jamarju/c64_test_tools/(threads)

Thread 2 (2018-07-21):

c64 dram test mega2560

toms001, 2018-07-21:
Hi,
just uploaded the c64 dram test to a ordinary mega2560 without any wires.
The test PASSes every time without an attached dram. How is this possible?
Regards,
Thomas

jamarju, 2018-07-21:
The mega2560 version of the RAM test outputs pass/fail on the serial output, unlike the 328p version, which uses the LED.

toms001, 2018-07-21:
That is not what i meant... if you have a mega2560 with nothing connected, it always says PASS.
I expected a different result with _no_ 64k x 4 connected

jamarju, 2018-07-21:
Ok, ok sorry, I see what you mean. Let me figure out what's going on here.

jamarju, 2018-07-21:
If you have a known working RAM chip wired up, could you please try the following change in line 118 of `w()`?

Replace this:
```
    PORTF &= 0b11110000;                              // ... no pull-ups
```

with this:
```
    PORTF |= 0b00001111;                              // keep pull-ups
```

Apparently written data gets latched by the pin circuitry or stored up in some small capacitance somehow. Pulling up the inputs before reading should pass the '1111' test and fail the others.

Closed 2018-07-22.

Thread 4 (2020-05-24):

Test says fail PLA but in another C64 the chip works normally

leonpierre, 2020-05-24:
I flashed your PLA test program to an Arduino Uno and wired it to the PLA (8700-001) as declared and figured out that with a working PLA (Fujitsu 251064-01) everything looks OK but with the mentioned MOS 8700-001 I got LED flashes -> FAILED.

So if I put the "failed" 8700-001 to a working C64 everything is good! I have a video of the setup here: https://www.youtube.com/watch?v=KTHi8Ji6yds

Btw. any idea what could be wrong with this image after boot: https://imgur.com/a/6CjX6wW

Thank you.

jamarju, 2020-05-24:
You are getting two errors (1 flash + 3 flashes), so the faulty pins are F0 and F2. Can you double check the wiring especially on those two pins? Does the high half (F4...F7) also show errors?

No idea about your boot image, but looks like RAM to me according to the pictorial guide: https://derbian.webs.com/c64diag/index.htm

leonpierre, 2020-05-24:
I wired it according to your PLA Test draft.

One question:
PLA F2/6 --- C4  | [ ]A4/SDA
PLA F2/7 --- C5  | [ ]A5/SCL

is this by intention to wire F2 to A4 and A5? Because I did it like

PLA F2/6 --- C4  | [ ]A4/SDA
PLA F3/7 --- C5  | [ ]A5/SCL <==== F3 not F2

jamarju, 2020-05-24:
Yes, that was a typo. You're right, Arduino A5 should go to PLA F3.

As for your original problem, try adding a couple more nops in the peek function. Ie: instead of this:

```
  asm("nop"); // 62.5 ns
  asm("nop"); // 62.5 ns
```

Do this:

```
  asm("nop"); // 62.5 ns
  asm("nop"); // 62.5 ns
  asm("nop"); // 62.5 ns
  asm("nop"); // 62.5 ns
```

That will give twice as much time for the PLA to propagate the signals.

leonpierre, 2020-05-25:
I did your changes and tested it again with equal results. Here is a video of the same setup but with Fujitsu 251064-01 instead of MOS 8700-001 PLA:

https://www.youtube.com/watch?v=bH1ezJzycxE

It's weird for me that both PLA IC's are working in a real C64 but not with your PLA test. Any suggestions what could be wrong?

Thank you!

jamarju, 2020-05-25:
Did you connect /CE to GND? It's hard to tell in your video but it seems to me that you left it floating.

leonpierre, 2020-05-25:
Nope, but if I connect /CE to GND I have permanent LED flashes.

jamarju, 2020-05-25:
Can you record another video of the permanent flashes while /CE is connected to GND?

leonpierre, 2020-05-27:
Voila: https://youtu.be/ocNNEUnGQsc

jamarju, 2020-05-28:
That chip is PASSING the test.

A failure is indicated by a 1 second pause followed by flashing a number of times depending on the erroring pin, followed by another 1 second pause.

Closed 2020-05-28.
