jamarju/c64_test_tools/c64_rom_test/charom.h

// GENERATED WITH:
// xxd -i charom.bin >charom.h
#ifndef __CHAROM_H__
#define __CHAROM_H__

#include <avr/pgmspace.h>

const PROGMEM unsigned char characters_901225_01_bin[] = {
  0x3c, 0x66, 0x6e, 0x6e, 0x60, 0x62, 0x3c, 0x00, 0x18, 0x3c, 0x66, 0x7e,
  0x66, 0x66, 0x66, 0x00, 0x7c, 0x66, 0x66, 0x7c, 0x66, 0x66, 0x7c, 0x00,
  0x3c, 0x66, 0x60, 0x60, 0x60, 0x66, 0x3c, 0x00, 0x78, 0x6c, 0x66, 0x66,
  0x66, 0x6c, 0x78, 0x00, 0x7e, 0x60, 0x60, 0x78, 0x60, 0x60, 0x7e, 0x00,
  0x7e, 0x60, 0x60, 0x78, 0x60, 0x60, 0x60, 0x00, 0x3c, 0x66, 0x60, 0x6e,
  0x66, 0x66, 0x3c, 0x00, 0x66, 0x66, 0x66, 0x7e, 0x66, 0x66, 0x66, 0x00,
  0x3c, 0x18, 0x18, 0x18, 0x18, 0x18, 0x3c, 0x00, 0x1e, 0x0c, 0x0c, 0x0c,
  0x0c, 0x6c, 0x38, 0x00, 0x66, 0x6c, 0x78, 0x70, 0x78, 0x6c, 0x66, 0x00,
  0x60, 0x60, 0x60, 0x60, 0x60, 0x60, 0x7e, 0x00, 0x63, 0x77, 0x7f, 0x6b,
  0x63, 0x63, 0x63, 0x00, 0x66, 0x76, 0x7e, 0x7e, 0x6e, 0x66, 0x66, 0x00,
  0x3c, 0x66, 0x66, 0x66, 0x66, 0x66, 0x3c, 0x00, 0x7c, 0x66, 0x66, 0x7c,
  0x60, 0x60, 0x60, 0x00, 0x3c, 0x66, 0x66, 0x66, 0x66, 0x3c, 0x0e, 0x00,
  0x7c, 0x66, 0x66, 0x7c, 0x78, 0x6c, 0x66, 0x00, 0x3c, 0x66, 0x60, 0x3c,
  0x06, 0x66, 0x3c, 0x00, 0x7e, 0x18, 0x18, 0x18, 0x18, 0x18, 0x18, 0x00,
  0x66, 0x66, 0x66, 0x66, 0x66, 0x66, 0x3c, 0x00, 0x66, 0x66, 0x66, 0x66,
  0x66, 0x3c, 0x18, 0x00, 0x63, 0x63, 0x63, 0x6b, 0x7f, 0x77, 0x63, 0x00,
  0x66, 0x66, 0x3c, 0x18, 0x3c, 0x66, 0x66, 0x00, 0x66, 0x66, 0x66, 0x3c,
  0x18, 0x18, 0x18, 0x00, 0x7e, 0x06, 0x0c, 0x18, 0x30, 0x60, 0x7e, 0x00,
  0x3c, 0x30, 0x30, 0x30, 0x30, 0x30, 0x3c, 0x00, 0x0c, 0x12, 0x30, 0x7c,
  0x30, 0x62, 0xfc, 0x00, 0x3c, 0x0c, 0x0c, 0x0c, 0x0c, 0x0c, 0x3c, 0x00,
  0x00, 0x18, 0x3c, 0x7e, 0x18, 0x18, 0x18, 0x18, 0x00, 0x10, 0x30, 0x7f,
  0x7f, 0x30, 0x10, 0x00, 0x00, 0x00, 0x00, 0x00, 0x00, 0x00, 0x00, 0x00,
  0x18, 0x18, 0x18, 0x18, 0x00, 0x00, 0x18, 0x00, 0x66, 0x66, 0x66, 0x00,
  0x00, 0x00, 0x00, 0x00, 0x66, 0x66, 0xff, 0x66, 0xff, 0x66, 0x66, 0x00,
  0x18, 0x3e, 0x60, 0x3c, 0x06, 0x7c, 0x18, 0x00, 0x62, 0x66, 0x0c, 0x18,
  0x30, 0x66, 0x46, 0x00, 0x3c, 0x66, 0x3c, 0x38, 0x67, 0x66, 0x3f, 0x00,
  0x06, 0x0c, 0x18, 0x00, 0x00, 0x00, 0x00, 0x00, 0x0c, 0x18, 0x30, 0x30,
  0x30, 0x18, 0x0c, 0x00, 0x30, 0x18, 0x0c, 0x0c, 0x0c, 0x18, 0x30, 0x00,
  0x00, 0x66, 0x3c, 0xff, 0x3c, 0x66, 0x00, 0x00, 0x00, 0x18, 0x18, 0x7e,
  0x18, 0x18, 0x00, 0x00, 0x00, 0x00, 0x00, 0x00, 0x00, 0x18, 0x18, 0x30,
  0x00, 0x00, 0x00, 0x7e, 0x00, 0x00, 0x00, 0x00, 0x00, 0x00, 0x00, 0x00,
  0x00, 0x18, 0x18, 0x00, 0x00, 0x03, 0x06, 0x0c, 0x18, 0x30, 0x60, 0x00,
  0x3c, 0x66, 0x6e, 0x76, 0x66, 0x66, 0x3c, 0x00, 0x18, 0x18, 0x38, 0x18,
  0x18, 0x18, 0x7e, 0x00, 0x3c, 0x66, 0x06, 0x0c, 0x30, 0x60, 0x7e, 0x00,
  0x3c, 0x66, 0x06, 0x1c, 0x06, 0x66, 0x3c, 0x00, 0x06, 0x0e, 0x1e, 0x66,
  0x7f, 0x06, 0x06, 0x00, 0x7e, 0x60, 0x7c, 0x06, 0x06, 0x66, 0x3c, 0x00,
  0x3c, 0x66, 0x60, 0x7c, 0x66, 0x66, 0x3c, 0x00, 0x7e, 0x66, 0x0c, 0x18,
  0x18, 0x18, 0x18, 0x00, 0x3c, 0x66, 0x66, 0x3c, 0x66, 0x66, 0x3c, 0x00,
  0x3c, 0x66, 0x66, 0x3e, 0x06, 0x66, 0x3c, 0x00, 0x00, 0x00, 0x18, 0x00,
  0x00, 0x18, 0x00, 0x00, 0x00, 0x00, 0x18, 0x00, 0x00, 0x18, 0x18, 0x30,
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
};

#endif
