jamarju/c64_test_tools/(commit log)

2018-01-23 Added 64K x 4bit DRAM test (Arduino MEGA only)
2018-07-22 fix #2: all tests pass with floating inputs
    Because of input buffers capacitance acting as an actual DRAM cell (?)
    [c64_dram_test_mega2560.ino]
2020-05-24 fix #4: PLA pinout typo
    [c64_pla_test.ino]
